CyberYeti/Diy-3D-Printer/XY Motion System/Motion System Assembly.png

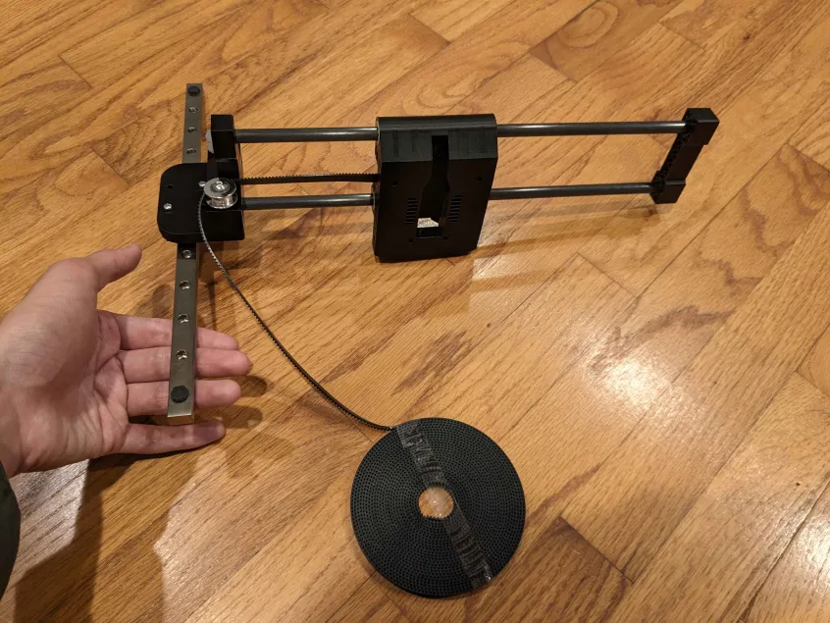
XY Motion System/Motion System Assembly.png
