CyberYeti/Diy-3D-Printer/Extruder/Photos/Holder and Cover-Front.png

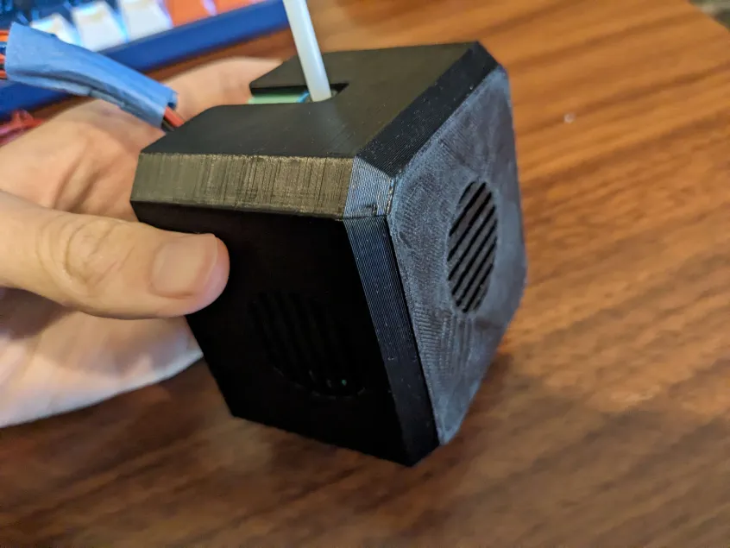
Extruder/Photos/Holder and Cover-Front.png
