CyberYeti/Diy-3D-Printer/Extruder/Photos/Cover-Back.png

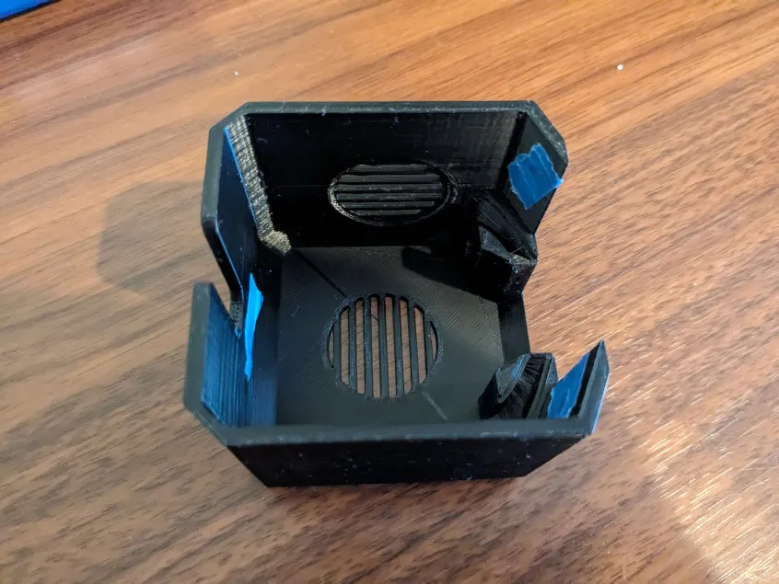
Extruder/Photos/Cover-Back.png
