CyberYeti/Diy-3D-Printer/Extruder/Photos/Cover-Front.png

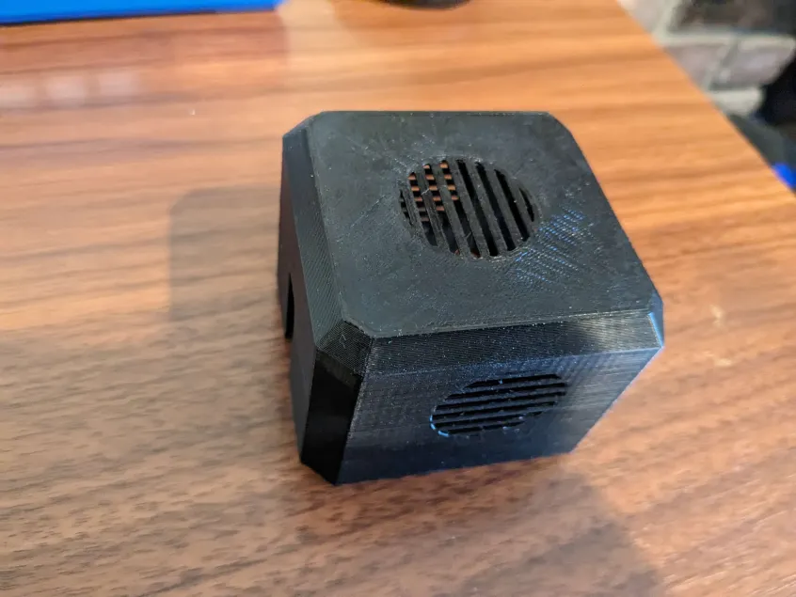
Extruder/Photos/Cover-Front.png
