CyberYeti/Diy-3D-Printer/Extruder/Photos/Holder and Cover-Back.png

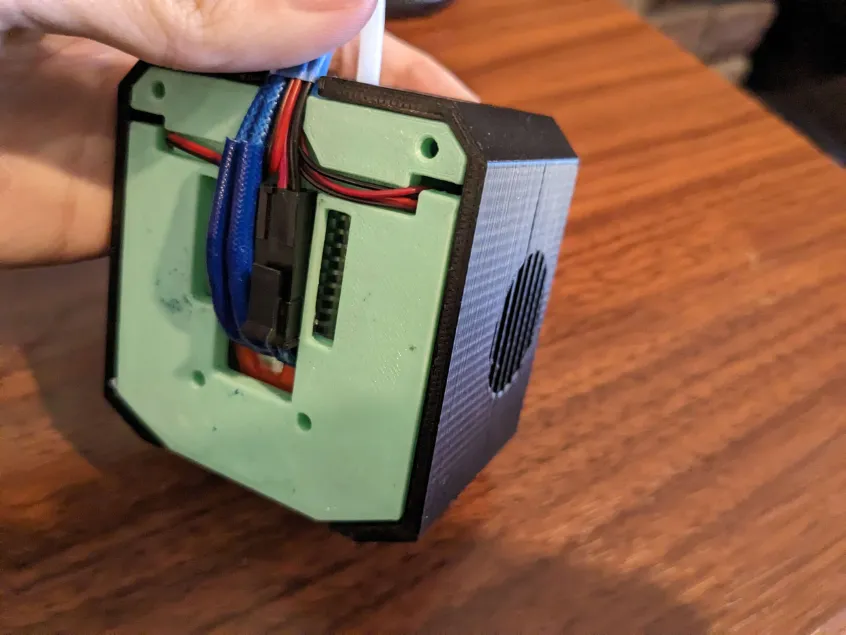
Extruder/Photos/Holder and Cover-Back.png
