CyberYeti/Diy-3D-Printer/Extruder/Photos/Holder and Cover-Bottom.png

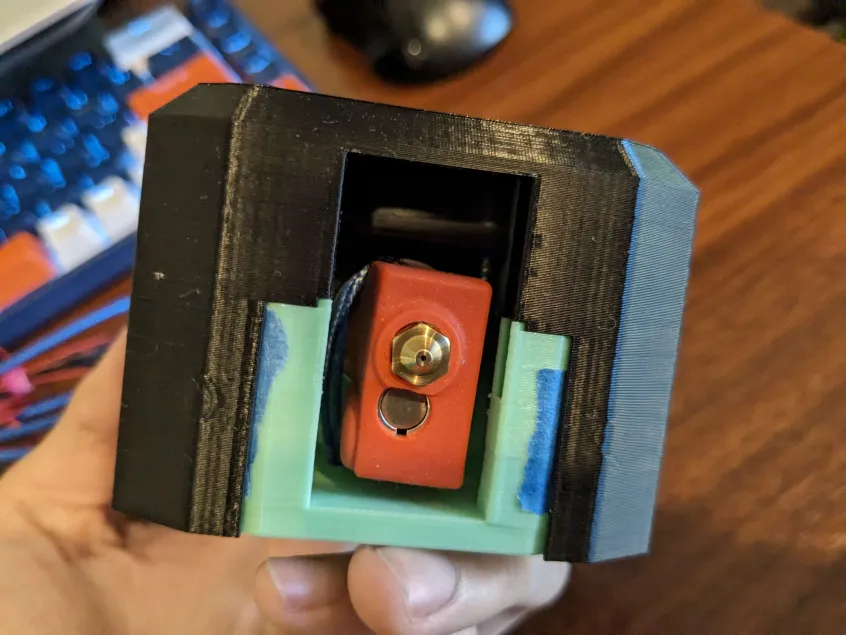
Extruder/Photos/Holder and Cover-Bottom.png
