CyberYeti/Diy-3D-Printer/Extruder/Photos/Holder-Angled.png

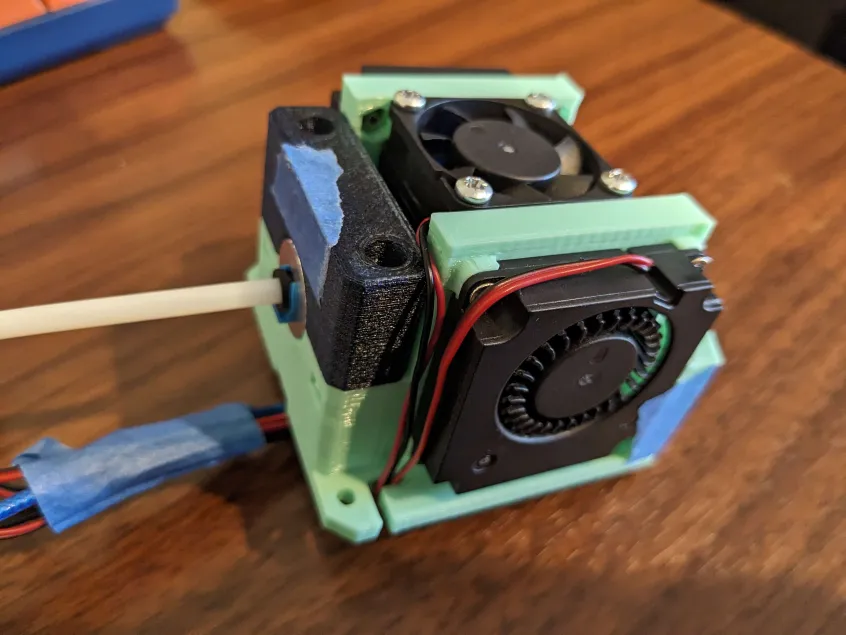
Extruder/Photos/Holder-Angled.png
