CyberYeti/Diy-3D-Printer/Extruder/Photos/Holder-Back.png

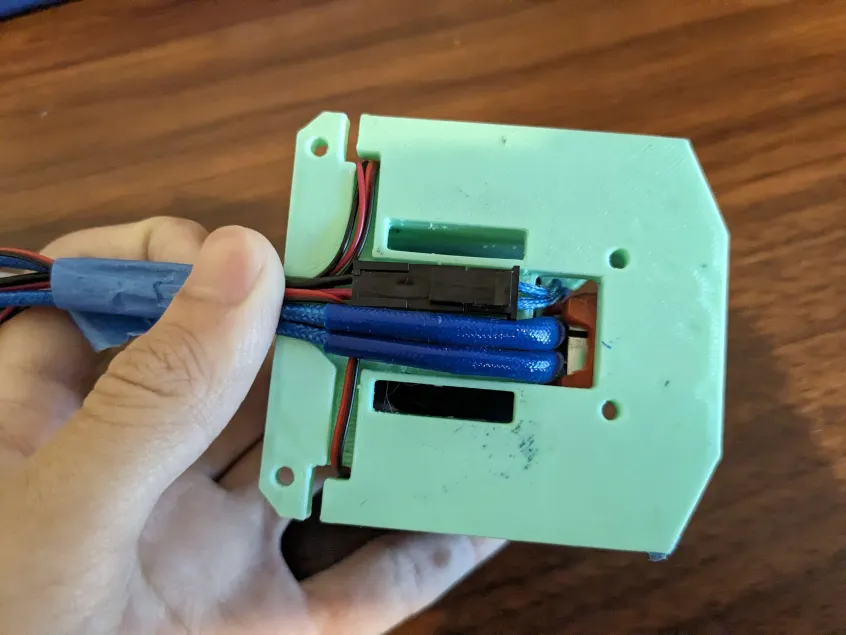
Extruder/Photos/Holder-Back.png
