CyberYeti/Diy-3D-Printer/Extruder/Photos/Holder-Bottom.png

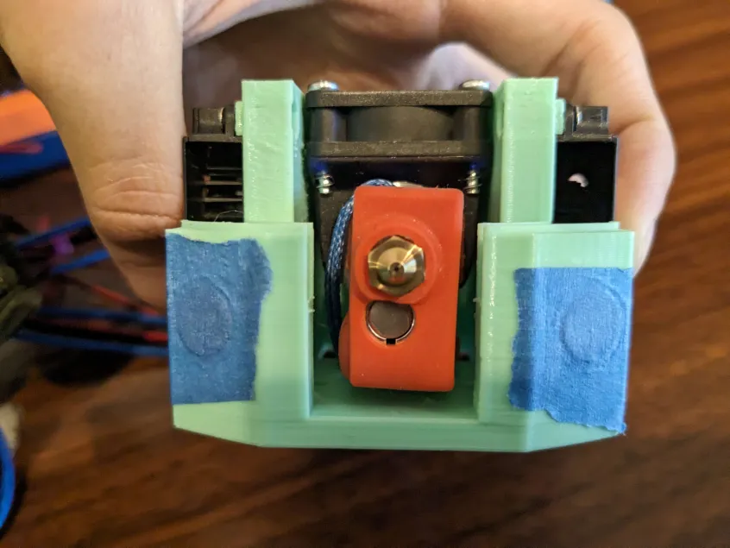
Extruder/Photos/Holder-Bottom.png
