CyberYeti/Diy-3D-Printer/Extruder/Photos/Holder-Front.png

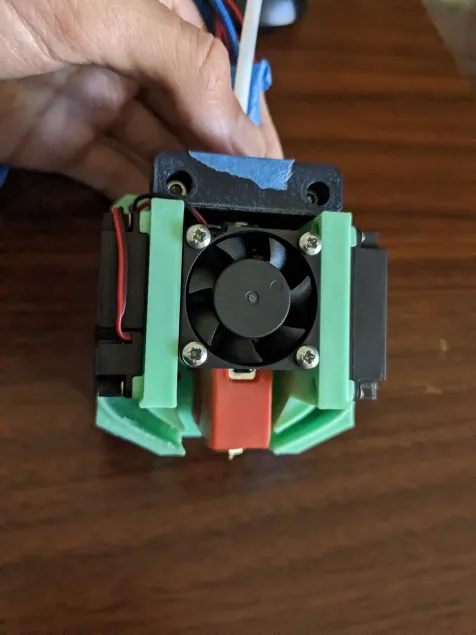
Extruder/Photos/Holder-Front.png
