CyberYeti/Diy-3D-Printer/Extruder/CAD/Extruder Mount.step

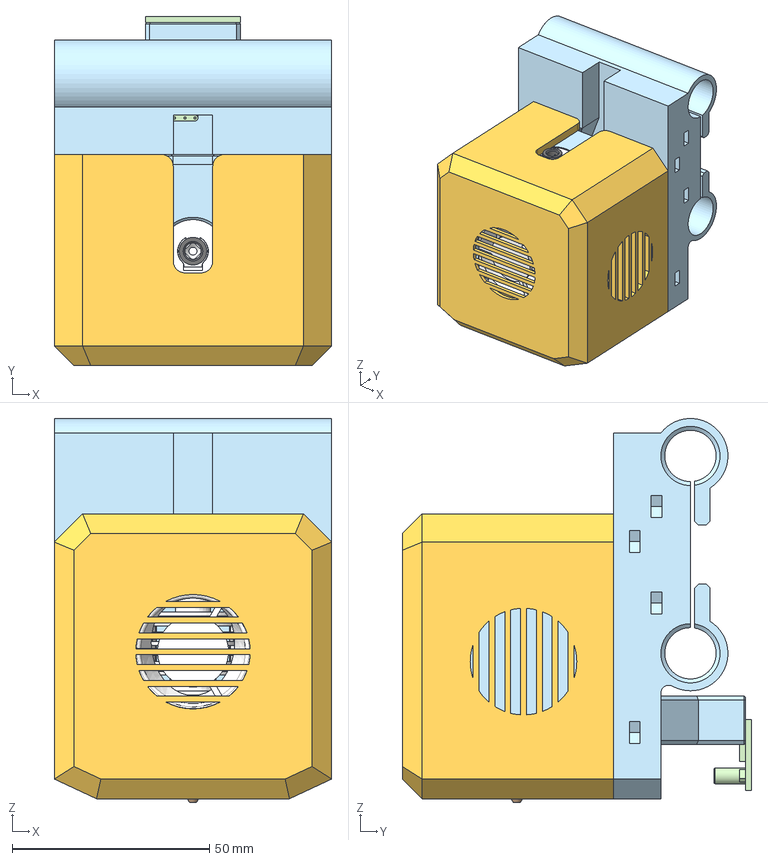
[picture p11: CAD file, 2024-05-05]
Extruder/CAD/Extruder Mount.step
70.3 x 88.5 x 97.3 mm
Igus Holder
Hotend
Cover
Duet 3d IR Sensor
Base
