CyberYeti/Diy-3D-Printer/(commit log)

2023-09-11 Initial Extruder CAD
    This is my original design for the extruder. It has many issues, the most prominent being that it doesn't account for wires and the tolerances being too tight.
    [4010 Fan.step, H-Bot Cable Holder.step, IR Sensor.step, Igus DryLin RJ4JP_01-08_8mm.step, Igus Holder.step]
2023-09-24 Version 2.1
    The start of a major rework of the extruder design to factor into account the wires.
    This version changes the main section of the extruder to be wider and to have holes on the top for the wires.
    It also has a different Igus Slide Holder that doesn't block the IR Sensor's wires. It does so by converting the slides to be on a vertical instead of horizontal plane.
    [Extruder Mount.step, H-Bot Cable Holder.step, Igus Holder.step]
2023-09-26 Improved Igus Holder - Extruder Mount Connection
    Added holes on the top of the Extruder Mount and Igus Holder for more secure connection
    [Extruder Mount.step, Igus Holder.step]
2023-10-04 Added IR sensor mount
    Added a mount for the ABL IR sensor
    [IR Holder.step]
2023-10-04 Added Place for belts to connect to
    Added little loops for 6mm timing belts to connect to on the Igus Holder.
    [Igus Holder.step]
2024-02-28 Creation of a branch focused on redesigning the extruder
    The old extruder mount had a lot of issues. The main ones are as follows:
    -The previous design was too hard to assemble and disassemble. With all the wires going through various holes and the way the screw holes were placed, it would be very difficult to take apart for maintenance and part replacement.
    -Not modular enough. In the future, if I were to add or change certain components, it would be hard to do so without completely redesigning the mount.
    -The Igus Bearing holders were using the deformation of a thin plastic casing to hold it. That may deform and loosen through use.
    [4010 Fan.step, E3D Volcano.step, Extruder Mount.step, IR Holder.step, IR Sensor.step, Igus DryLin RJ4JP_01-08_8mm.step, Igus Holder.step]
2024-02-28 An initial idea of the redesigned extruder mount
    The main idea with this design was to have a sturdy holder for the Igus Bearings which everything else could be screw mounted on. This version also uses screw-clamped mounts for the Igus Bearings in order to make their insertion easier and more long-lasting.
    Major Issues:
    -The lowest point of the mount is lower than the extruder. (The mount would touch the build plate before the extruder does.)
    -The Igus bearings were still able to slide out of the mount. Screwing tighter is not a fix because it would compress the bearing, preventing it from sliding on the linear rod.
    Minor Issues
    -A bit bulky. Should probably reduce its size.
    [Igus Holder.step]
2024-03-02 Designed a compression holder for the Igus Bearings
    Compression bearing holders are simply easier to design and print. Also, it uses more sturdy flexures to have a tighter grip on the bearing. Furthermore, this design does not use the ridges the old holder uses. This design purely uses frictional forces to hold the bearing in place. This allows it to be relatively easy to remove when needed.
    [Compression Fit Test.step]
2024-03-07 Designed a new Igus holder using the compression Igus Mounts
    Very basic design. More modifications are needed for things such as screw holes, and belt connection areas.
    [Igus Holder.step]
2024-03-19 Created an extruder mount
    While this extruder mount design is slightly more modular, the IR sensor is in a really bad place and there is no easy way to mount this assembly on to the Igus holder.
    [Extruder Mount.step]
2024-04-02 Redesign of the Extruder
    Very rough design for the extruder mount. Instead of trying to squeeze the IR sensor on the mount, I'm focusing on mounting the hotend and the fans. I am also attempting to use an embedded part cooling fan duct instead of a separate part.
    This version is still a very rough design that requires wire paths, mounting holes, and a top cover.
    [Extruder Mount.step, New Extruder Mount.step]
2024-04-22 Completed Extruder Mount with Wire Pathing and Ventilation
    The hotend is pretty close to the plastic and may need to increase spacing in the future
    [New Extruder Mount.step]
2024-04-23 Moved the fan duct away from the hotend and increased thin wall thickness
    Certain areas of the cover were too thin causing defects when printing. The part was thickened to fix this.
    [New Extruder Mount.step]
2024-04-29 Added the images of the new design
    The blue tape is only used to temporarily hold the magnets in place. The final version will use super glue to hold the magnets in place.
2024-04-29 Minor modifications to the extruder mount
    Added counter sunk holes for the screw heads
    Added better wiring path for the extruder cooling fan
    Increased the space around the extruder heat sink
    [Compression Fit Test.step, Extruder Mount.step, Igus Holder.step, New Extruder Mount.step]
2024-05-05 Basic Shape of the Igus Holder
    Still missing a method to mount the belt to it
    [Extruder Mount.step]
2024-06-13 Changes to belt tensioner and minor misc changes
    Made the non-adjustable belt tensioner to be held by tension instead of by screw.
    Removed the extra thickness in the igus holder that initially prevented the bearings from sliding all the way through.
    Fixed the size of the IR sensor mounting holes to allow the screw to directly screw into the plastic.
2024-06-17 Initial version of the Y carriage for the motion system
2024-06-20 Second Version of the Y Carriage
    More stable and switched to a screw clamp for the rods for easier removal.
2024-06-22 Lowered the y carriage a bit
